sonictruth/famiterm/screenshots/s1.jpg

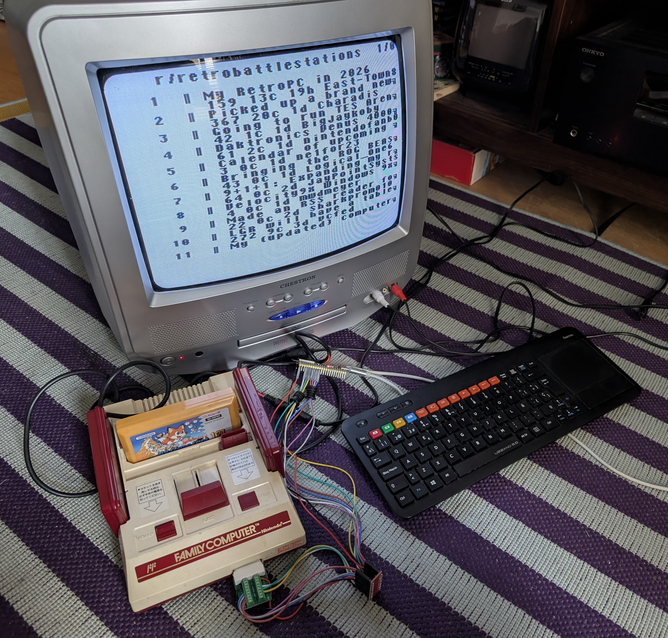
screenshots/s1.jpg
